Herald-0f-l1fe/smart-clothes-rack/README.md

# AutoRack — умная вешалка, которая сама распределяет одежду по рейке

**Проектное предложение ВЦП ПЦП, осень 2026**
Авторы: **Ковальков Борис**, группа Б01-502,  **Сидорова Елена**, группа Б01-511
Ментор: **Азамат Георгиевич Тавитов**

---

## О чём проект

Напольная система хранения одежды, которая сама раздвигает каретки с крючками,
когда на вешалку добавляют новую вещь, и компактно сдвигает их обратно, когда вещь
снимают. Плюс подсвечивает занятые и свободные места, чтобы человеку не приходилось
искать, куда повесить куртку.

Идея родилась из бытовой проблемы: на обычной вешалке вещи всегда сбиваются в одну
сторону. Приходишь с работы, кидаешь куртку на первое попавшееся плечико — и через
пару недель половина рейки забита, половина пустая, перевешивать лень. AutoRack
делает это сам и заодно показывает, что свободно.

Название рабочее: в текстах проекта мы называем прототип **AutoRack**, в
заявке — «Умная вешалка».

## Проблема

* Место на перекладине расходуется неравномерно: вещи кучкуются у краёв, середина
  рейки простаивает.
* Чтобы найти свободное место, пользователю приходится раздвигать плечики руками.
* Обычная вешалка никак не сообщает о своём состоянии и не экономит энергию, потому
  что энергии ей и не нужно — а у нас моторы, и об этом приходится думать отдельно.
* В помещении не нужны решения «для улицы» с дождевыми датчиками, зато нужно
  аккуратное хранение и взаимодействие «подошёл — увидел — взял».

## Как это работает

Механика построена на одной простой идее: **натяжение пружины расправляет ткань,
а ткань раздвигает крючки.**

1. Основа — горизонтальная фанера. Внутри рейки натянут стальной трос, на него
   надета пружина растяжения. Один её конец закреплён на боковине, ко второму
   привязана верёвка, которую тянет мотор через барабан.
2. PIR-датчик ловит приближение человека и «будит» систему, включая подсветку.
3. ESP32 включает мотор натяжения. Мотор наматывает верёвку и растягивает пружину
   вдоль троса на рабочую длину рейки.
4. Поверх пружины лежит тканевая лента. В расслабленном состоянии она скомкана и
   драпируется, при растяжении пружины расправляется в гладкую ленту.
5. Крючки стоят поверх ткани: при расправлении ленты они автоматически разъезжаются
   вдоль рейки, при ослаблении натяжения — съезжаются в компактное положение.
6. На каждом крючке — FSR-датчик усилия, по которому система понимает, занято место
   или нет (порог срабатывания около 200 г).
7. Сверху по V-slot профилю 2020 ездит каретка на роликах. Она сдвигает крючки
   локально, без полного изменения натяжения пружины.
8. Если пользователь подошёл, но за 5 секунд ничего не снял и не повесил, система
   выбирает свободный крючок и локально раздвигает соседей — показывает пустое место.
9. Когда вещь сняли, система фиксирует падение веса на крючке и возвращает локально
   смещённые крючки в равномерное распределение.
10. Адресная лента WS2812B подсвечивает свободные места зелёным, занятые — красным.
    Пассивный зуммер коротко подтверждает завершение перемещения.
11. Нет движения 5 минут — режим энергосбережения: свет гаснет, пружина возвращается
    в ненатянутое состояние.

## Целевые параметры

| Параметр | Значение |
|---|---|
| Точность определения одежды на крючке | не менее 95 % |
| Время реакции системы и перераспределения | не более 10 с |
| Длина рабочей рейки / вместимость | 1000 мм / до 16 кареток |
| Ожидание действия пользователя перед показом свободного крючка | 5 с |
| Время локального перемещения крючков верхней кареткой | не более 5 с |
| Исполнительные механизмы | 4 (мотор натяжения, привод верхней каретки, адресная LED-лента, зуммер) |
| Типы датчиков | 3 (PIR, датчики веса/усилия на крючках, датчик освещённости) |

## Задачи проекта

1. Спроектировать механику прототипа в CAD: направляющая рейка, конструкция кареток,
   система передачи троса и пружины.
2. Подобрать и интегрировать элементную базу: микроконтроллер, драйвер шагового
   двигателя, массив датчиков, исполнительные механизмы.
3. Написать ПО для ESP32: конечный автомат, алгоритм равномерного распределения,
   профили скорости мотора.
4. Изготовить детали: лазерная резка несущих конструкций из фанеры 6 мм, 3D-печать
   кареток, шкивов и креплений из PLA/PETG.
5. Собрать прототип с аккуратным кабель-менеджментом.
6. Провести комплексное тестирование: калибровка порогов FSR-датчиков, отладка
   алгоритма энергосбережения.
7. Спроектировать верхнюю подвижную каретку на роликах с приводом и элементами для
   локального сдвига крючков вдоль ткани.
8. Реализовать алгоритм ожидания 5 с, выбора свободного крючка, локального
   раздвижения соседних крючков и возврата системы в равномерное положение после
   снятия вещи.

## Элементная база

**Управление.** ESP32 DevKit V1 (38-pin, Type-C) — обработка данных с датчиков,
управление мотором натяжения, приводом каретки, подсветкой и зуммером.

**Исполнительные механизмы.**
* Шаговый двигатель NEMA 17 (17HS4401, 1.7 А) + драйвер DRV8825 с радиатором и
  барабаном для намотки тяговой верёвки — растяжение пружины.
* Шаговый двигатель 28BYJ-48 с драйвером ULN2003 (либо мотор-редуктор с энкодером) —
  верхняя подвижная каретка.
* Адресная светодиодная лента WS2812B (60 LED/м, IP30).
* Пассивный зуммер KY-006 (5 В).

**Сенсоры.**
* PIR-датчик HC-SR501 — детекция присутствия.
* FSR-датчики усилия 402 (1–20 кг) на крючках: 16 рабочих + 2 запасных. Опрос массива
  через 16-канальные мультиплексоры CD74HC4067. В первой версии сознательно выбраны
  FSR вместо тензодатчиков с HX711: нам нужна не масса, а бинарное «занято/свободно».
* Датчик освещённости BH1750 (I²C) — автояркость подсветки.
* Концевые выключатели KW11-3Z — ограничение хода пружины и верхней каретки.

**Питание.** Блок 12 В / 5 А (60 Вт), понижающие DC-DC LM2596 (12 → 5 В, 2 А) для
ESP32 и LED, тумблер KCD1 (ON–OFF, 10 А), предохранитель 5 А.

**Механика.** Стальной трос 1.5 мм (7×7) как направляющая, пружина растяжения
(D = 15 мм, L0 = 400 мм, d = 1.8 мм, k ≈ 1–2 Н/мм), капроновая верёвка 2 мм, барабан,
верхняя каретка на роликах V-slot с профилем 2020 (1000 мм), подшипники 608ZZ,
тканевая лента поверх пружины, крючки с креплениями под датчики усилия.

## Программная часть

Прошивка — это один конечный автомат, в котором нас интересуют четыре вещи: не дёргать
мотор без причины, не путать занятое место со свободным, попадать в 10 секунд на
перераспределение и не жрать ток, когда в комнате никого нет.

Основные состояния:

* `SLEEP` — пружина ослаблена, подсветка выключена, ждём PIR.
* `WAKE` — человек подошёл, включаем подсветку, опрашиваем массив FSR.
* `DISTRIBUTE` — растягиваем пружину и раскладываем крючки равномерно.
* `HINT` — 5 с без действий: выбираем свободный крючок и локально раздвигаем соседей
  верхней кареткой, подсвечиваем место.
* `RESTORE` — зафиксировали снятие вещи по падению веса, возвращаем крючки в
  равномерное положение.
* `COOLDOWN` — 5 минут без движения, гасим свет и ослабляем пружину.

Профиль скорости мотора — трапециевидный с разгоном и торможением, чтобы ткань не
дёргалась и крючки не слетали. Позиция каретки контролируется концевыми
выключателями и энкодером.

## Структура репозитория

```
smart-clothes-rack/
├── README.md                 этот файл
├── LICENSE                   MIT
├── TOPICS.md                 тема, описание и теги репозитория
├── docs/
│   ├── АПП.pdf               проектное предложение (аналитическая часть)
│   └── ВОМ.pdf               bill of materials, список закупок
├── firmware/
│   └── README.md             заметки по будущей прошивке ESP32
├── hardware/                 CAD, эскизы, файлы для лазерной резки и 3D-печати
└── images/                   фото сборки, эскизы, схемы
```

Прошивка и CAD ещё в работе — папки заполняются по мере прохождения этапов.

## Этапы работ

| Этап | Что делаем | Результат |
|---|---|---|
| 1 | Проектирование в CAD: рейка, каретки, передача | Чертежи, готовые к резке |
| 2 | Заказ компонентов по BOM | Комплект на 2 итерации сборки |
| 3 | Лазерная резка фанеры, печать деталей | Комплект механики |
| 4 | Сборка механической части, трос и пружина | Вешалка раскладывается вручную |
| 5 | Монтаж электроники, кабель-менеджмент | Прототип питается и шевелится |
| 6 | Прошивка ESP32, конечный автомат | Автоматическое распределение |
| 7 | Калибровка FSR, отладка энергосбережения | Измеренные характеристики |
| 8 | Испытания, оформление документации | Защита проекта |

Электронику заказываем не позднее 20 сентября: доставка с AliExpress идёт 15–30 дней,
а сроки РР — 27 сентября / 4 октября.

## Аналоги и чем мы отличаемся

**1. NU EDU TECHNO Smart Clothes Rack (Arduino Project Hub).** Прототип уличной
сушилки на ESP32: датчик дождя убирает одежду, мотор постоянного тока 12 В наматывает
леску и перемещает всю конструкцию, ИК-датчики TCRT5000 работают концевыми
выключателями, DHT22 следит за влажностью, а Blynk показывает состояние. Каркас из
ПВХ-труб и колёс от игрушечной машины.

Что полезно: подтверждает работоспособность лебёдочного принципа перемещения одежды
мотором — он родственен нашему пружинно-тросовому натяжению. Заимствуем две идеи:
концевые выключатели для калибровки крайних положений и уведомления о состоянии в
мобильном приложении.

Чем мы лучше: аналог решает только защиту от погоды, у него два фиксированных
положения (убрано/выдвинуто), нет определения занятости отдельных крючков и никакой
реакции на подход человека. Наш AutoRack работает в помещении, распределяет крючки по
данным сенсоров веса, реагирует на PIR и локально освобождает свободный крючок.

**2. Коммерческая потолочная умная электросушилка T03.** Серийная подъёмная сушилка:
опускается до 120 см, уходит под потолок, 20 фиксированных отверстий под крючки,
четыре выдвижные штанги 128–185 см, LED 46 Вт, до 25–35 кг, управление с пульта и
приложения, сертификация CE/RoHS/ISO.

Что полезно: подтверждает спрос на моторизованные вешалки; вертикальное хранение
под потолком идейно родственно нашему горизонтальному сжатию крючков в расслабленной
пружине. Заимствуем встроенную подсветку как вторичную функцию и подход к расчёту
грузоподъёмности привода.

Чем мы лучше: «умность» там заканчивается на подъёме и свете. Нет датчиков занятости,
детекции подхода и автоматического перераспределения, шаг между крючками задан
отверстиями и не адаптируется под количество вещей, горизонтальной оптимизации нет,
нужен капитальный потолочный монтаж, а цена готового изделия высокая.

Итого наша ниша: недорогой напольный прототип, который в реальном времени
распределяет вещи по рейке, определяет занятость позиций и подсказывает свободное
место светом.

## Бюджет

Смета целиком — в `docs/ВОМ.pdf`. Кратко по разделам:

| Раздел | Сумма, ₽ |
|---|---|
| Электроника и микроконтроллер | 2 185 |
| Силовая электроника и приводы | 2 285 |
| Индикация и звук | 460 |
| Механика и привод передачи | 1 755 |
| **Итого по позициям (22 шт.)** | **6 685** |
| Запас 10 % на брак и докупку | 670 |
| **ИТОГО** | **7 355** |

Запасные компоненты куплены осознанно на самые уязвимые при отладке узлы: FSR-датчики,
DRV8825, ESP32 и ролики каретки.

## Команда

| Участник | Группа | Контакты |
|---|---|---|
| Ковальков Борис | Б01-502 | GitHub: [@Herald-0f-l1fe](https://github.com/Herald-0f-l1fe) |
| Сидорова Елена | Б01-511 | @blswf |

Ментор: Азамат Георгиевич Тавитов.

## Документы

* [`docs/АПП.pdf`](docs/АПП.pdf) — проектное предложение: цель, задачи, целевые
  параметры, описание функционала, эскиз, элементная база, анализ аналогов.
* [`docs/ВОМ.pdf`](docs/ВОМ.pdf) — bill of materials: 22 позиции, цены, поставщики,
  примечания и допущения по узлам.
* [`TOPICS.md`](TOPICS.md) — тема проекта, описание и теги для оформления
  репозитория на GitHub.

## Лицензия

Код и документация — [MIT](LICENSE). Схемы, CAD-модели и фотографии можно
использовать со ссылкой на репозиторий.
