Herald-0f-l1fe/smart-clothes-rack/TOPICS.md

# Топик проекта

## Тема

**«Умная вешалка» (AutoRack)** — прототип напольной системы хранения одежды,
которая автоматически раздвигает каретки с крючками при добавлении новой вещи и
компактно сдвигает их при снятии, оптимизируя пространство рейки и давая
пользователю визуальную обратную связь.

Проектное предложение ВЦП ПЦП, осень 2026. Команда: Ковальков Борис (Б01-502),
Сидорова Елена (Б01-511). Ментор: Азамат Георгиевич Тавитов.

## Описание репозитория

```
AutoRack: прототип умной вешалки на ESP32. Сама раскладывает крючки по рейке,
определяет занятость мест FSR-датчиками и подсвечивает свободный крючок.
Механика — фанера, лазерная резка и 3D-печать.
```

Короткое описание:

```
Прототип напольной вешалки, которая сама распределяет одежду по рейке и
подсказывает свободное место светом.
```

## Теги

```
smart-wardrobe
clothes-rack
autorack
esp32
platformio
arduino-framework
stepper-motor
nema17
drv8825
ws2812b
fsr-sensor
pir-sensor
limit-switch
home-automation
smart-storage
laser-cutting
3d-printing
cad
diy-electronics
prototype
```
