Herald-0f-l1fe/smart-clothes-rack/docs/ВОМ.pdf

## AutoRack — Список закупок / BOM

Проектное предложение ВЦП ПЦП, осень 2026 Сидорова Е., Ковальков Б.

Составлено: 15 сентября 2026

### 1. Электроника и микроконтроллер

№ | Наименование | Кол-во | Цена, | Назначение / поставщик
1 2 3 4 5 6 | ESP32 DevKit V1 (38-pin, Type-C) PIR-датчик HC-SR501 Датчик освещённости BH1750 (I²C) FSR-датчик усилия 402 (1–20 кг) Мультиплексор CD74HC4067 (16-канальный) Резисторы 10 кОм (0.25 Вт) | 2 шт. 1 шт. 1 шт. 18 шт. 2 шт. 20 шт. | 450 90 110 140 95 30 | Основной контроллер; 1 шт. — запас. AliExpress / Ozon Детекция присутствия. Ozon Автояркость подсветки. Ozon Датчики занятости крючков; 16 рабочих + 2 запас. AliExpress Опрос массива FSR; 1 рабочий + 1 запас. ЧипДип Делители напряжения для FSR. ЧипДип
Подытог по разделу 1 | | | | 2 185

### 2. Силовая электроника и приводы

№ | Наименование | Кол-
во
Цена, | Назначение / поставщик
7 | Шаговый двигатель
NEMA 17 (17HS4401,
1.7 А)
1 шт. | 850 | Основной привод натяжения
пружины. Ozon

8 Драйвер DRV8825 (с
радиатором)
2 шт. | 180 | Управление NEMA 17; 1
рабочий + 1 запас. Ozon
9 Шаговый двигатель
28BYJ-48 + ULN2003

1
компл.

250 Привод верхней каретки. AliExpress
10 Блок питания 12 В, 5 А
(60 Вт)
1 шт. | 650 | Питание моторов. Ozon

11 DC-DC LM2596
(понижающий, 12→5 В,
2 А)
2 шт. | 95 | Питание ESP32 и LED; 1+1 запас. Ozon
12 | Тумблер KCD1
(ON–OFF, 10 А)
1 шт. | 45 | Включение системы. ЧипДип
13 | Держатель
предохранителя +
предохранитель 5 А
1 шт. | 35 | Защита силовой цепи. ЧипДип
Подытог по разделу 2 | 2 285

### 3. Индикация и звук

№ | Наименование | Кол-во | Цена, | Назначение / поставщик
14 15 | LED-лента WS2812B (60 LED/м, IP30) Пассивный зуммер KY-006 (5 В) | 1 м 2 шт. | 380 40 | Индикация свободных/занятых мест. Ozon Звуковое подтверждение; 1+1. Ozon
Подытог по разделу 3 | | | | 460

### 4. Механика и привод передачи

№ | Наименование | Кол- во | Цена, | Назначение / поставщик
16 | Стальной трос 1.5 мм (оцинкованный, 7×7) | 2 м | 120 | Направляющая пружины. Строительный рынок
17 | Пружина растяжения, D = 15 мм, L0 = 400 мм, d = 1.8 мм | 1 шт. | 220 | Упругий элемент. Пружины-на-заказ / Ozon
18 | Верёвка капроновая 2 мм | 3 м | 60 | Тяга к мотору. Строительный рынок
19 | Концевые выключатели KW11-3Z | 4 шт. | 70 | Ограничители хода; крайние положения пружины и каретки. Ozon
20 | Ролики V-slot (POM) для каретки | 6 шт. | 85 | Ходовые опоры верхней каретки. AliExpress
21 | Алюминиевый V-slot профиль 2020, 1000 мм | 1 шт. | 450 | Направляющая верхней каретки. Ozon
22 | Подшипник 608ZZ | 4 шт. | 45 | Опоры барабана и каретки. Ozon
Подытог по разделу 4 | 1 755

2

Итого по позициям 1–22: | 6 685
Запас 10 % на брак и докупку: | 670
ИТОГО БЮДЖЕТ ПРОЕКТА: 7 355

Примечания и допущения

1. Датчики веса. В первой версии прототипа выбраны FSR-датчики усилия вместо тензодатчиков (HX711 + load cell): задача состоит не в измерении массы, а в бинарном определении занятости крючка (порог срабатывания ∼200 г). Это снижает сложность и стоимость узла.
2. Пружина растяжения. Параметры (D, L0, жёсткость k) уточняются после расчёта усилия натяжения. Ориентировочно k ≈ 1–2 Н/мм, что позволяет растягивать её на 600 мм с усилием 600–1200 Н, достаточным для расправления ткани и 16 крючков.
3. Запасные компоненты. FSR-датчики, DRV8825, ESP32 и ролики закуплены с запасом, так как это наиболее вероятные узлы выхода из строя при отладке.
4. Поставщики. Цены усреднены по Ozon, AliExpress и ЧипДип на сентябрь 2025–2026 года. При заказе с AliExpress сроки доставки — 15–30 дней, поэтому заказ электроники делается не позднее 20 сентября для соблюдения графика РР (27 сентября / 4 октября).

3
