Herald-0f-l1fe/smart-clothes-rack/ВОМ.xlsx

 |  | Прототип |  |  |  |  | Финал |  |  |  |  | Оба
# | Компонент | Кол-во | Цена | Зачем | # | Компонент | Кол-во | Цена | Зачем | # | Компонент | Кол-во | Цена | Где используется
1 | Микровыключатели KW11-3Z | 4 шт. | 80 ₽ | Детекция занятости носков (заменяет FSR) | 1 | NEMA 17 шаговый двигатель | 1 шт. | 850 ₽ | Привод натяжения (мощнее для 16 крючков) | 1 | ESP32 DevKit V1 | 2 шт. | 900 ₽ | Оба этапа (1+запас)
2 | Малая пружина (D=10 мм) | 1 шт. | 30 ₽ | Механизм натяжения прототипа | 2 | Драйвер DRV8825 | 2 шт. | 360 ₽ | Управление NEMA 17 (1 + запас) | 2 | PIR-датчик HC-SR501 | 1 шт. | 90 ₽ | Оба этапа
3 | Короткий кусок троса/верёвки | 1 м | 50 ₽ | Тяга прототипа | 3 | FSR-402 датчики усилия | 18 шт. | 2 520 ₽ | Детекция веса одежды (16 + 2 запас) | 3 | BH1750 датчик освещённости | 1 шт. | 110 ₽ | Оба этапа
 |  |  |  |  | 4 | Мультиплексор CD74HC4067 | 2 шт. | 190 ₽ | Опрос 16 FSR одним пином | 4 | LED-лента WS2812B | 1 м | 380 ₽ | Оба этапа
 |  |  |  |  | 5 | Резисторы 10 кОм | 20 шт. | 30 ₽ | Делители для FSR | 5 | Пассивный зуммер | 2 шт. | 80 ₽ | Оба этапа
 |  |  |  |  | 6 | Большая пружина (D=15 мм) | 1 шт. | 220 ₽ | Механизм натяжения финалки | 6 | БП 12 В, 5 А | 1 шт. | 650 ₽ | Оба этапа
 |  |  |  |  | 7 | Подшипники 608ZZ | 4 шт. | 180 ₽ | Опоры барабана | 7 | DC-DC LM2596 | 2 шт. | 190 ₽ | Оба этапа
 |  |  |  |  | 8 | Концевые выключатели | 4 шт. | 70 ₽ | Крайние положения финалки | 8 | Тумблер KCD1 | 1 шт. | 45 ₽ | Оба этапа
 |  |  |  |  | 9 | Ткань оксфорд 210D | 0.5 м | 180 ₽ | Драпировка финалки | 9 | Держатель предохранителя | 1 шт. | 35 ₽ | Оба этапа
 |  |  |  |  |  |  |  |  |  | 10 | 28BYJ-48 + ULN2003 | 2 компл. | 500 ₽ | Прототип: оба. Финалка: один переезжает как привод каретки
 |  |  |  |  |  |  |  |  |  | 11 | V-slot профиль 1000 мм | 1 шт. | 450 ₽ | Оба этапа (прототип использует часть длины)
 |  |  |  |  |  |  |  |  |  | 12 | Ролики POM для V-slot | 6 шт. | 510 ₽ | Оба этапа
 |  |  |  |  |  |  |  |  |  | 13 | Провода, разъёмы JST | компл. | 400 ₽ | Оба этапа
