Herald-0f-l1fe/smart-clothes-rack/models/Деталь1.stl

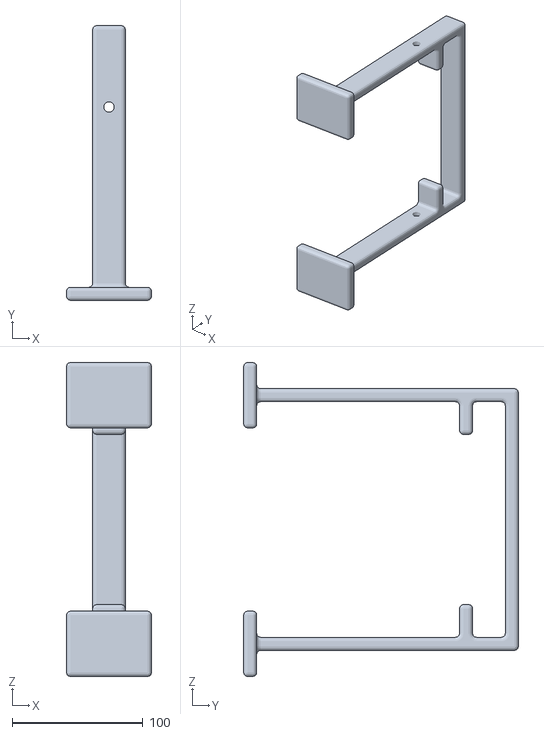
[picture p2: CAD file, 2026-10-22]
models/Деталь1.stl
65.0 x 210.0 x 240.0
