Herald-0f-l1fe/smart-clothes-rack/models/Левая_нога.stl

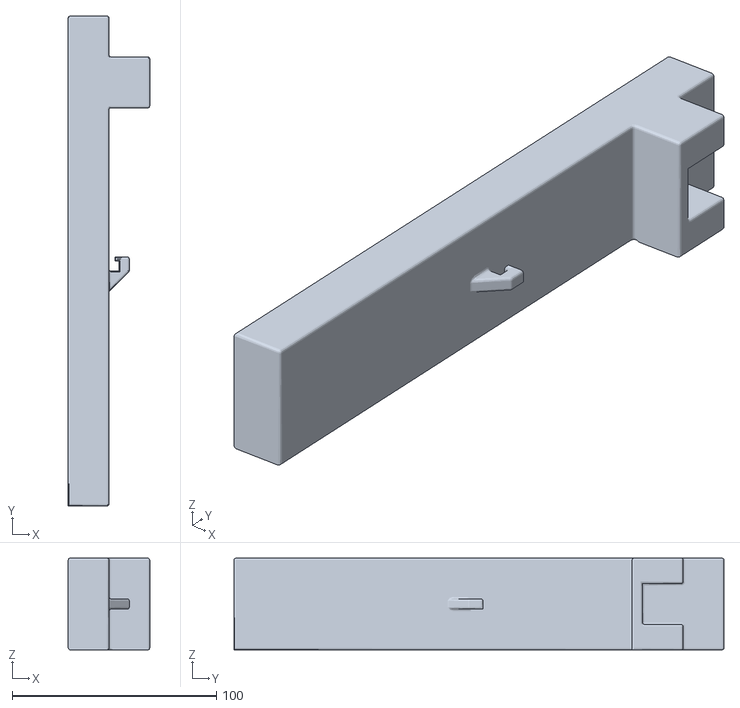
[picture p3: CAD file, 2026-10-22]
models/Левая_нога.stl
40.0 x 240.0 x 45.0
