Herald-0f-l1fe/smart-clothes-rack/models/Деталь.stl

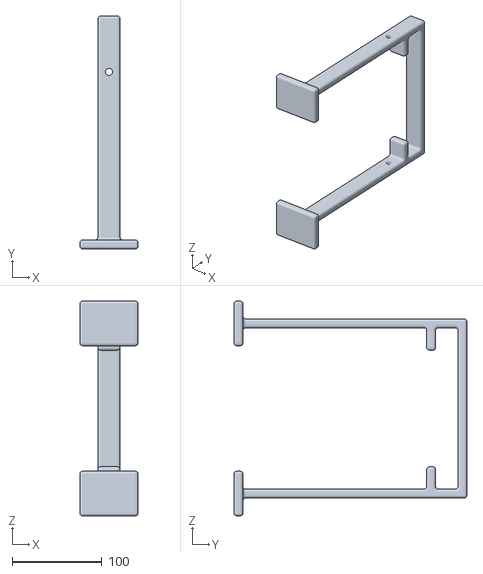
[picture p4: CAD file, 2026-10-22]
models/Деталь.stl
65.0 x 260.0 x 240.0
