Herald-0f-l1fe/smart-clothes-rack/(list of files, cad)

Other CAD files:
models/Правая_нога.stl
