Herald-0f-l1fe/smart-clothes-rack/(commit log)

2026-09-14 Документация проекта AutoRack: README, АПП, ВОМ и топик репозитория
    - README: описание идеи, механики, элементной базы, целей и этапов
    - docs: проектные PDF (анализ предметной области и ведомость материалов)
    - TOPICS.md: тема, описание и теги для оформления репозитория
    - MIT-лицензия, .gitignore, заметки по будущей прошивке
2026-09-22 Обновленный ВОМ
    [ВОМ.xlsx]
2026-09-27 esp32 test
2026-09-27 Buzzer, limit switch, and motion sensor test
    [02_buzzer_switches.ino, 03_pir.ino]
2026-09-27 stepper test
